PWr-M3/EuroMeasure-IonGaugeController/doc/Bottom_3D_render.png

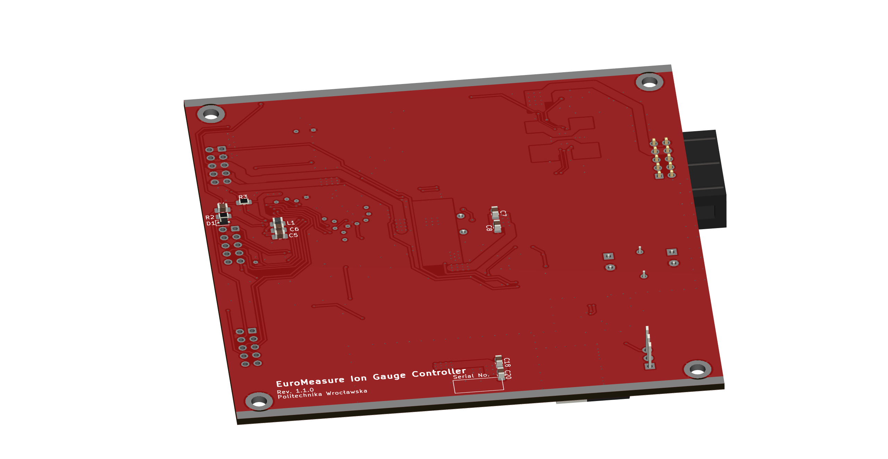
doc/Bottom_3D_render.png
