PWr-M3/EuroMeasure-IonGaugeController/doc/Top_3D_render.png

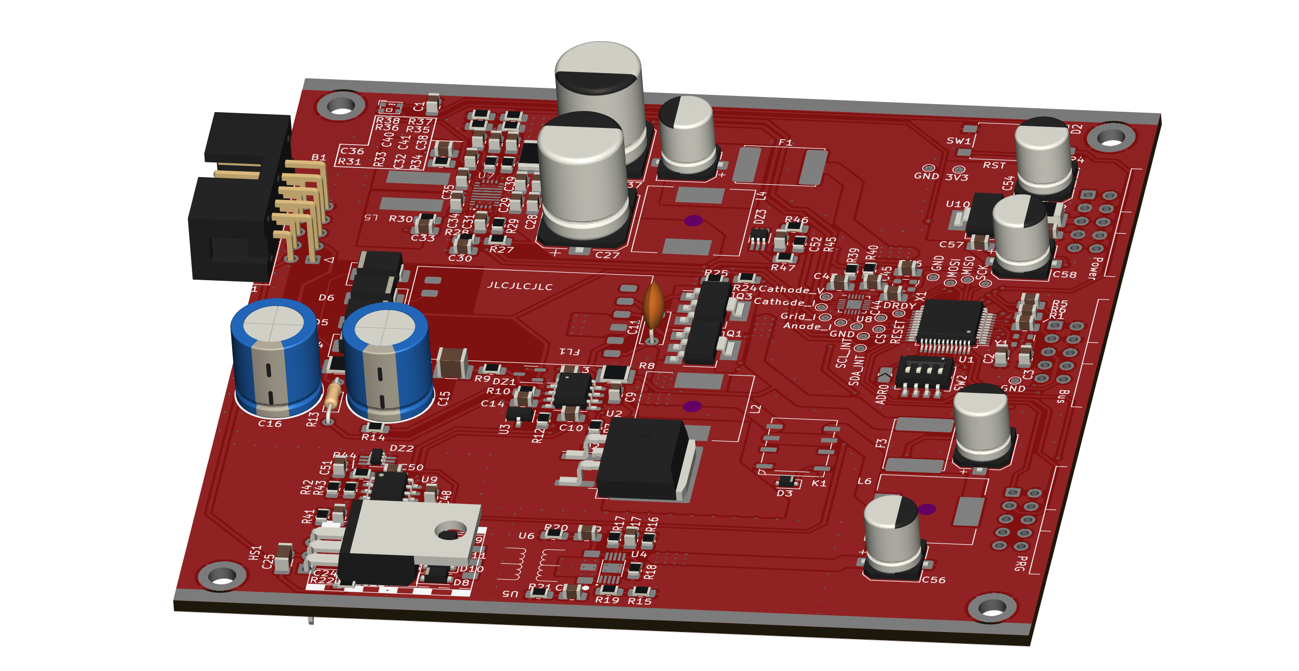
doc/Top_3D_render.png
