PWr-M3/EuroMeasure-IonGaugeController/doc/Schematic.pdf

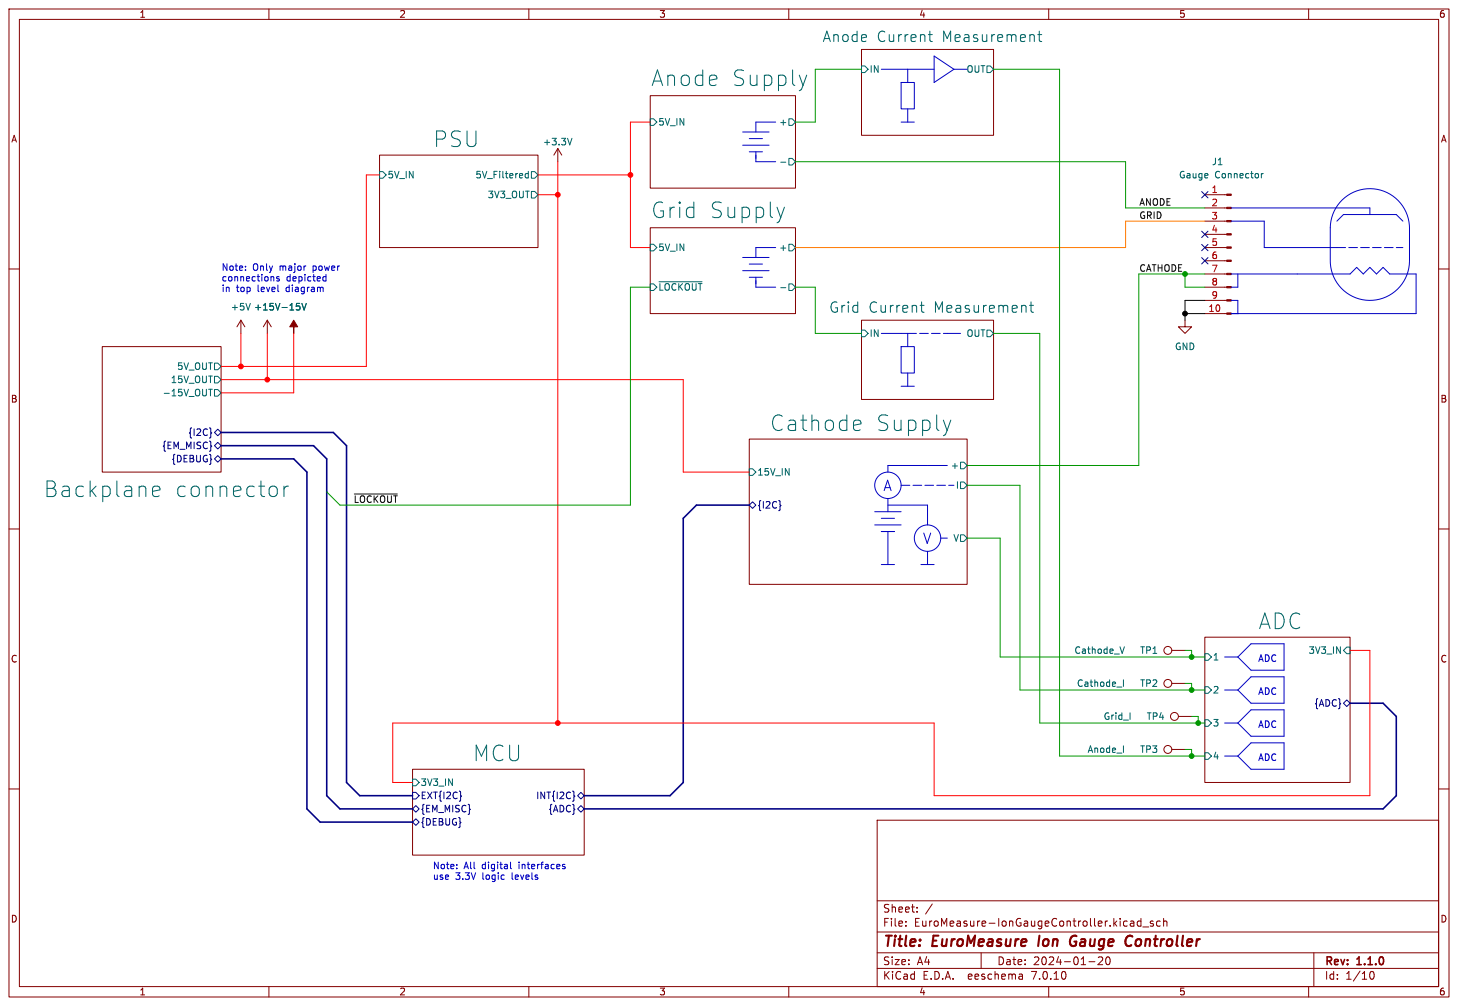
[picture p3: page 1]

in top level diagram

Id: 1/10 Title: EuroMeasure Ion Gauge Controller File: EuroMeasure-IonGaugeController.kicad_sch Sheet: /

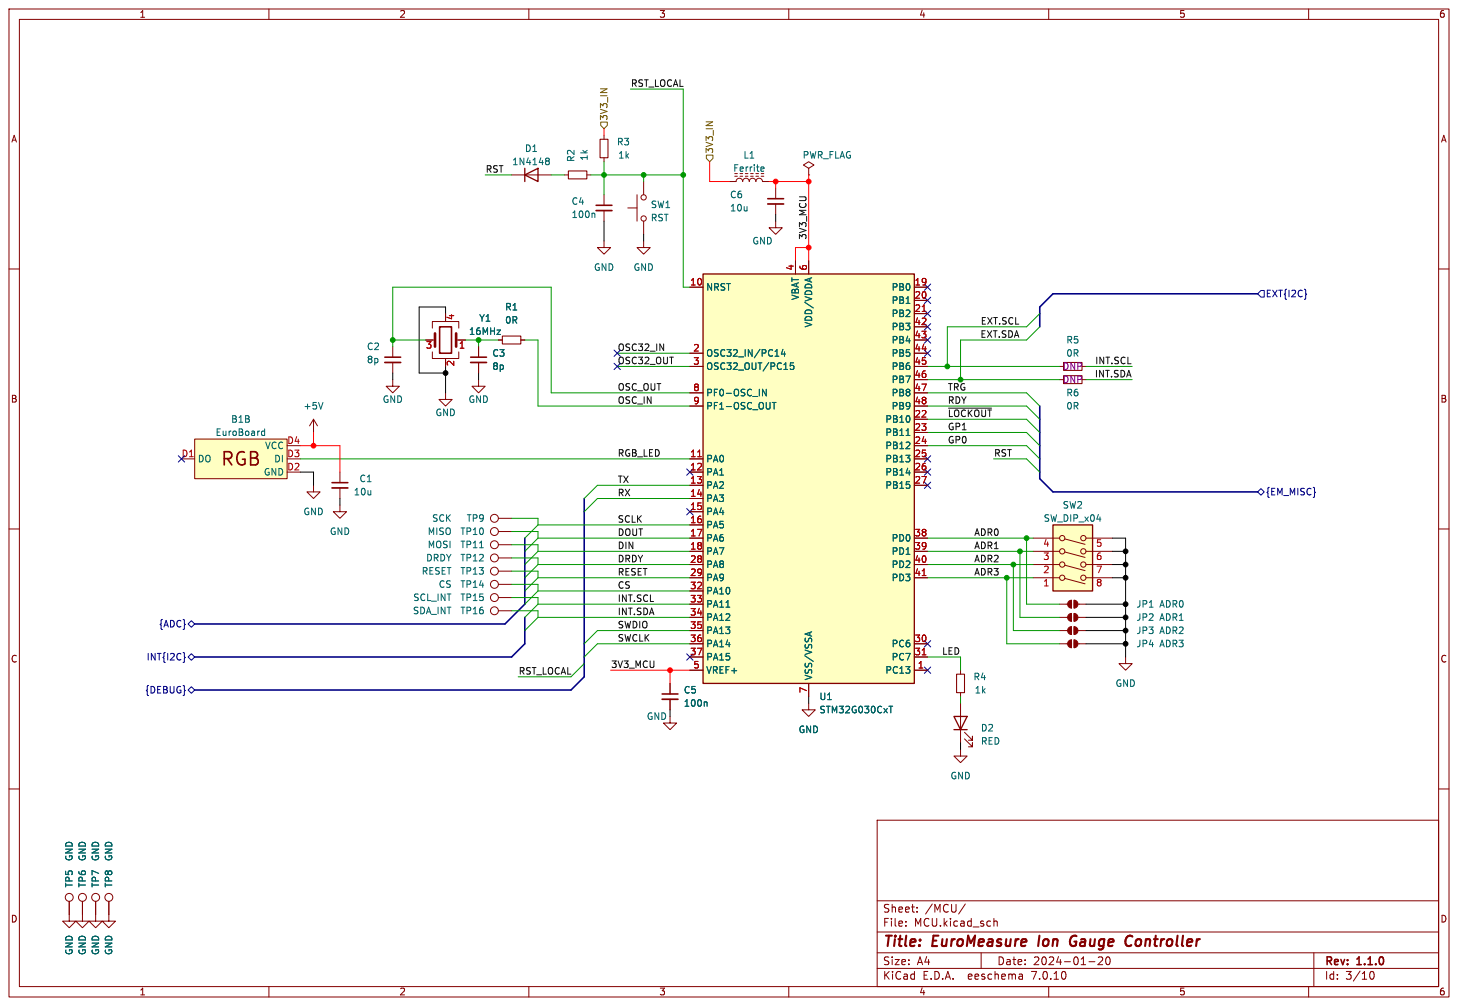
[picture p4: page 2]

EXT.SCL ~{LOCKOUT} RDY

SCLK DRDY DOUT DIN
RESET SWDIO

Id: 3/10 Title: EuroMeasure Ion Gauge Controller File: MCU.kicad_sch Sheet: /MCU/ GND

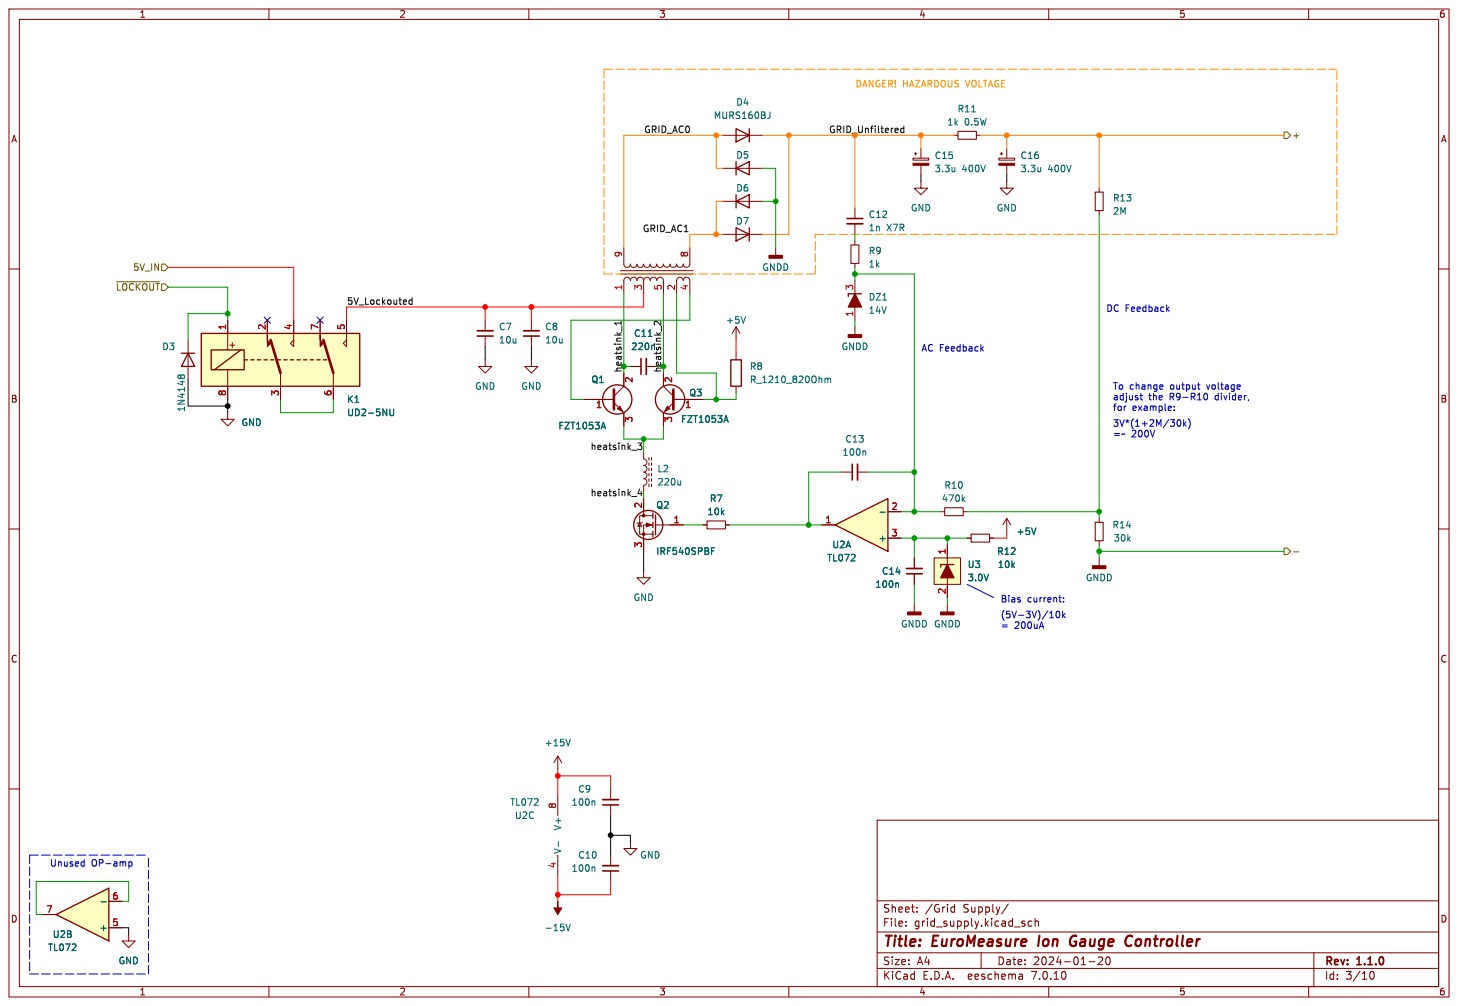
[picture p5: page 3]

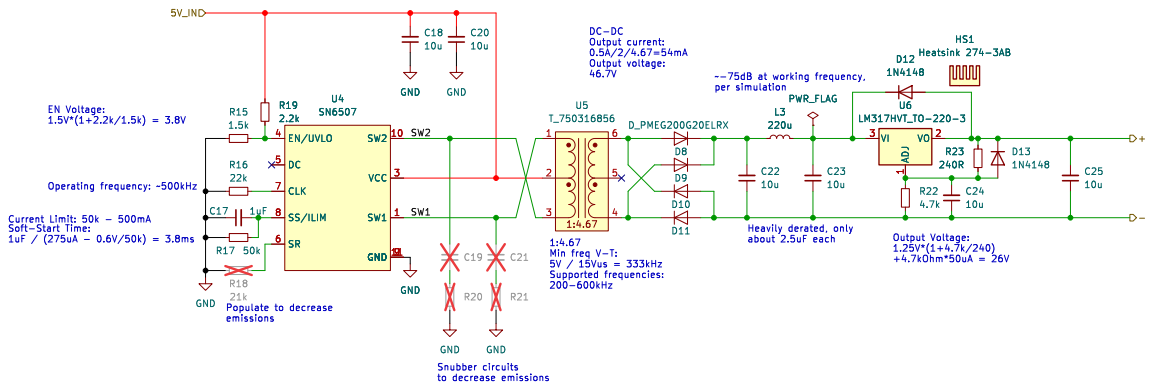
[picture p6: page 4]

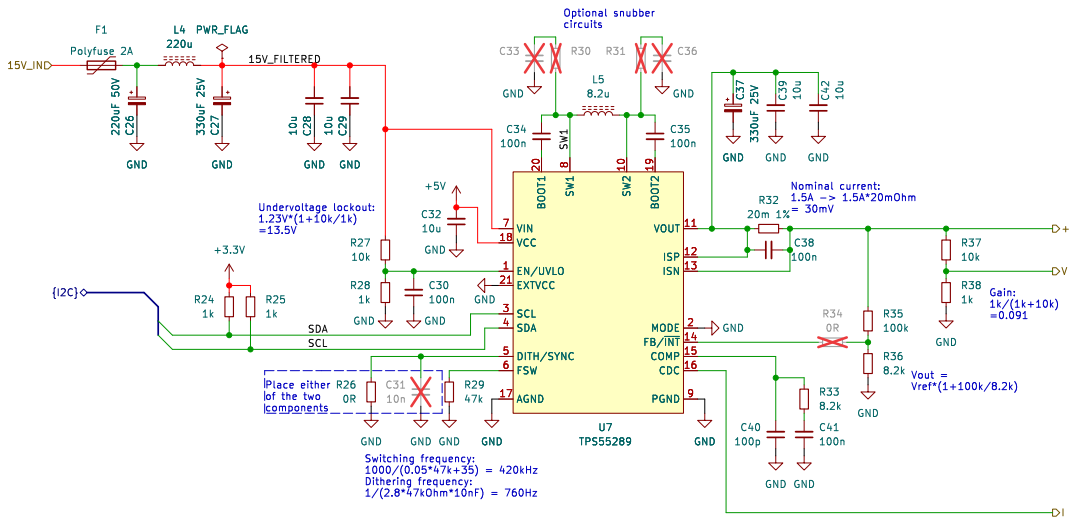
[picture p7: page 5]

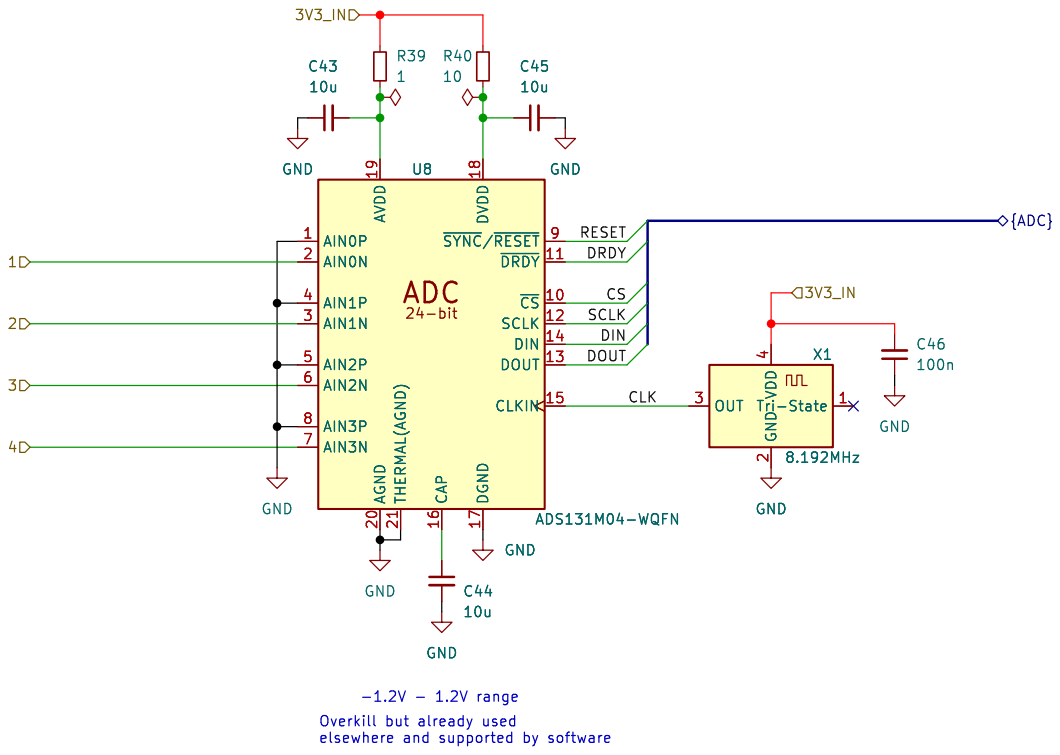
[picture p8: page 6]

{ADC} CLK DIN
SCLKCS DOUT RESET DRDY

Id: 6/10 Title: EuroMeasure Ion Gauge Controller File: adc.kicad_sch Sheet: /ADC/ GND

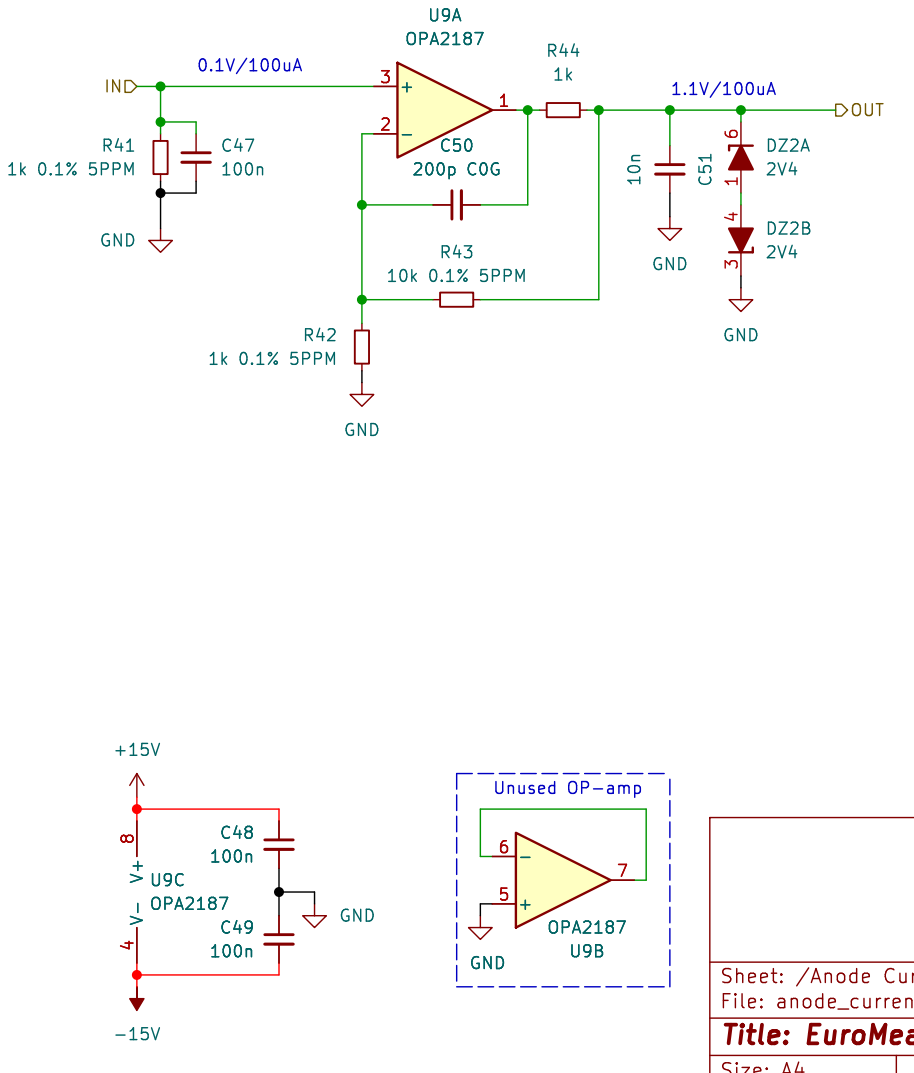
[picture p9: page 7]

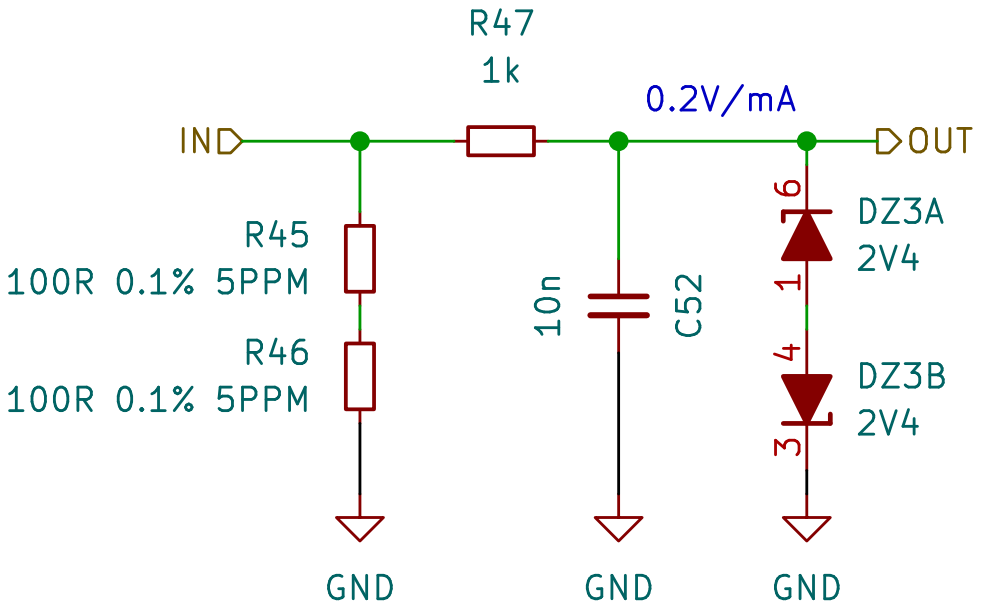
[picture p10: page 8]

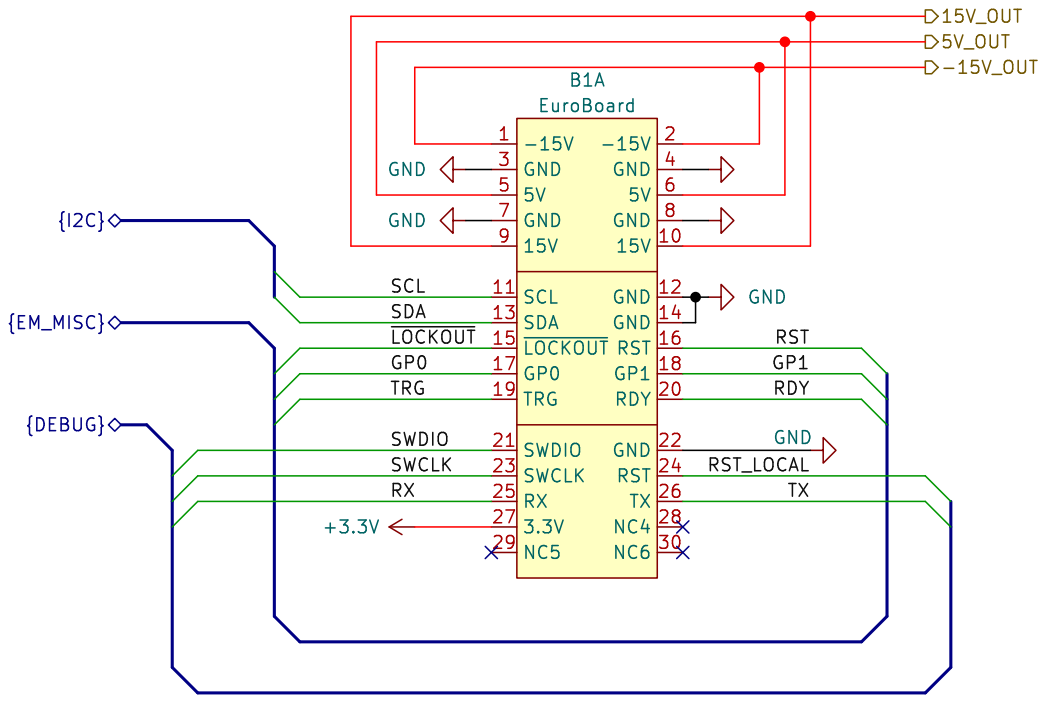
[picture p11: page 9]

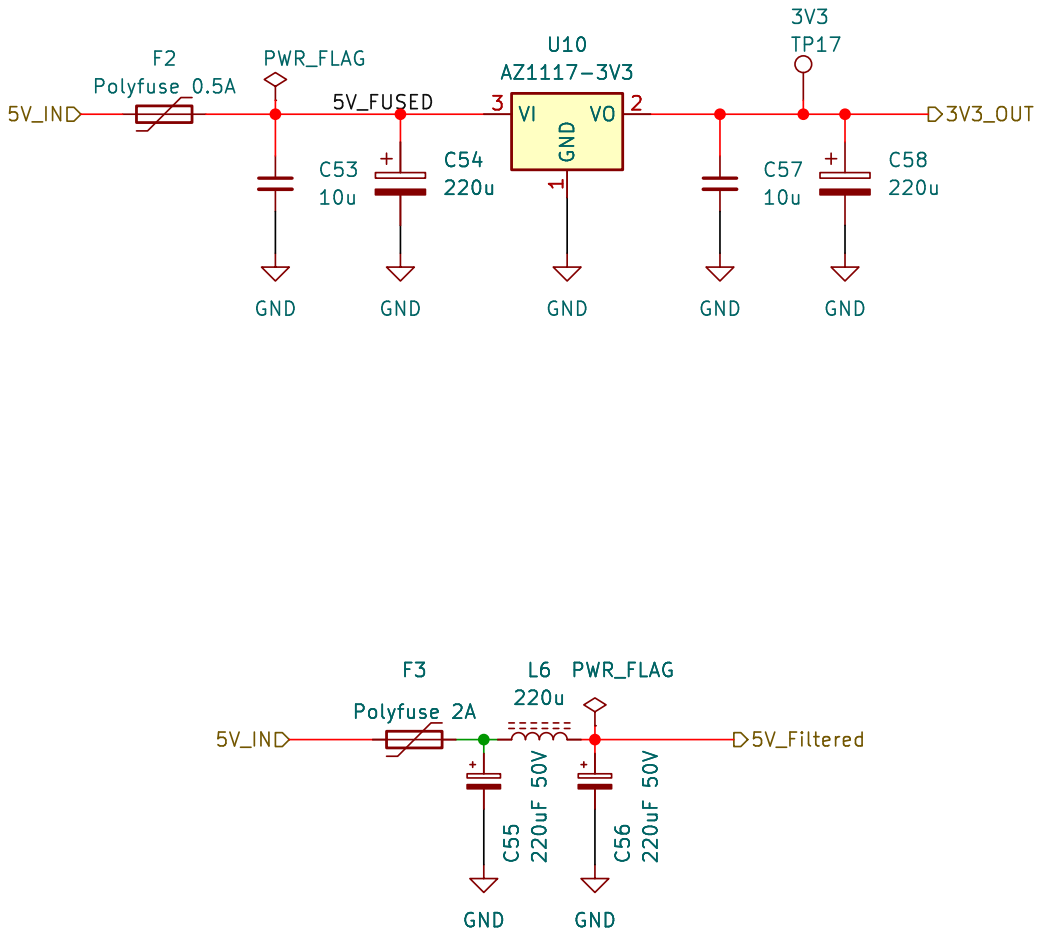
[picture p12: page 10]
