PWr-M3/EuroMeasure-IonGaugeController/doc/PCB.pdf

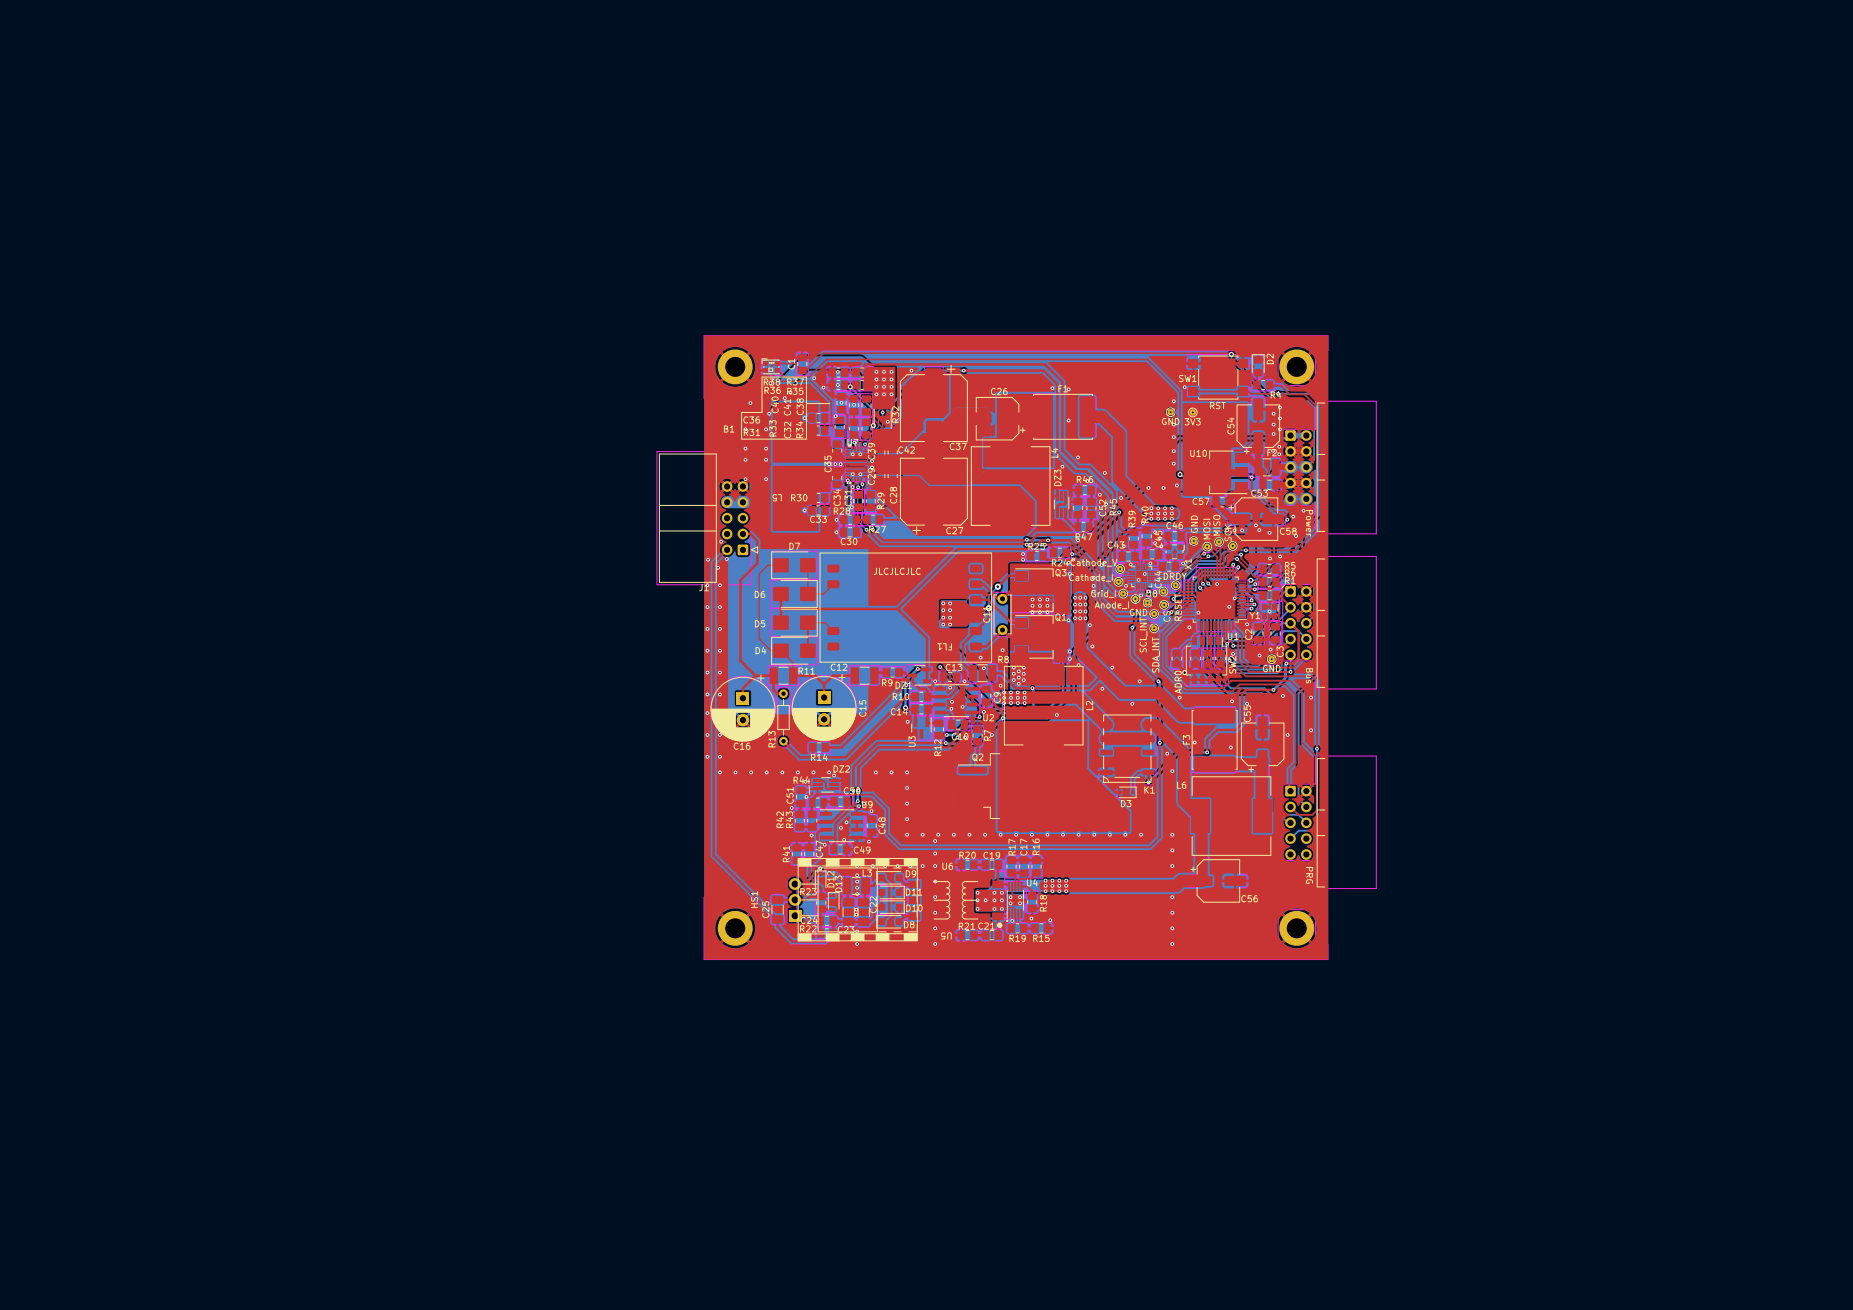
[picture p13: page 1]
