PWr-M3/EuroMeasure-IonGaugeController/EuroMeasure-IonGaugeController.kicad_pcb

## KiCad design EuroMeasure-IonGaugeController.kicad_pcb (2024-01-28)

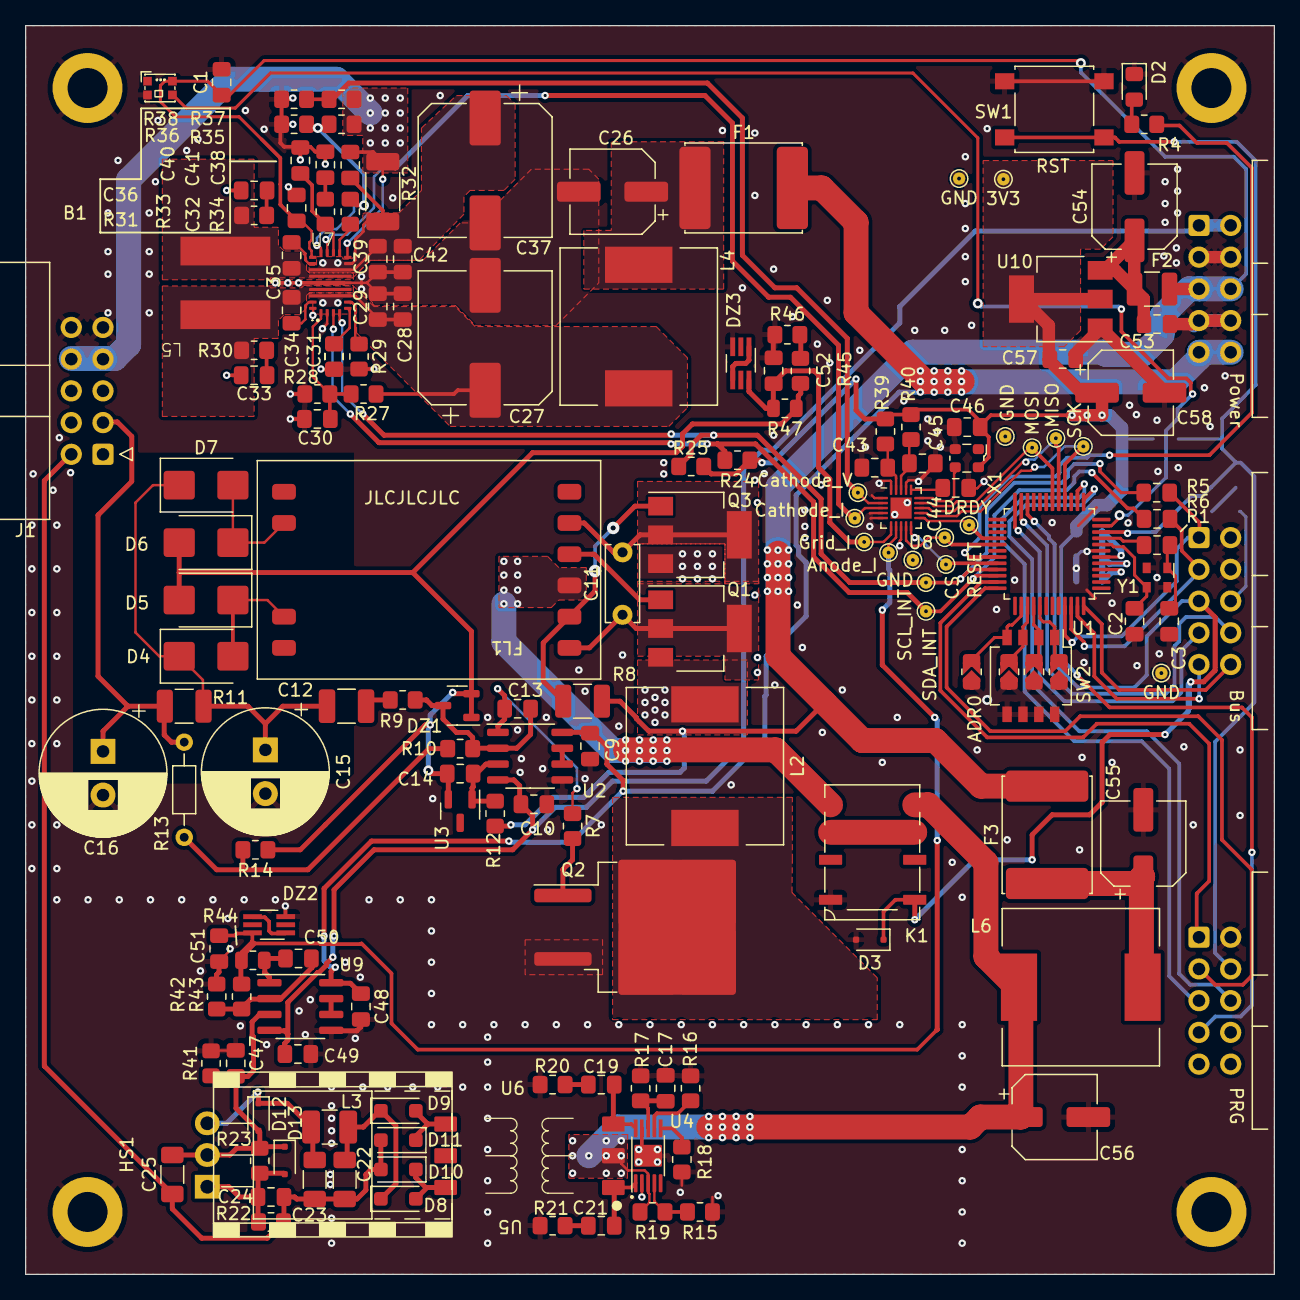
[picture p14: board EuroMeasure-IonGaugeController.kicad_pcb from above]

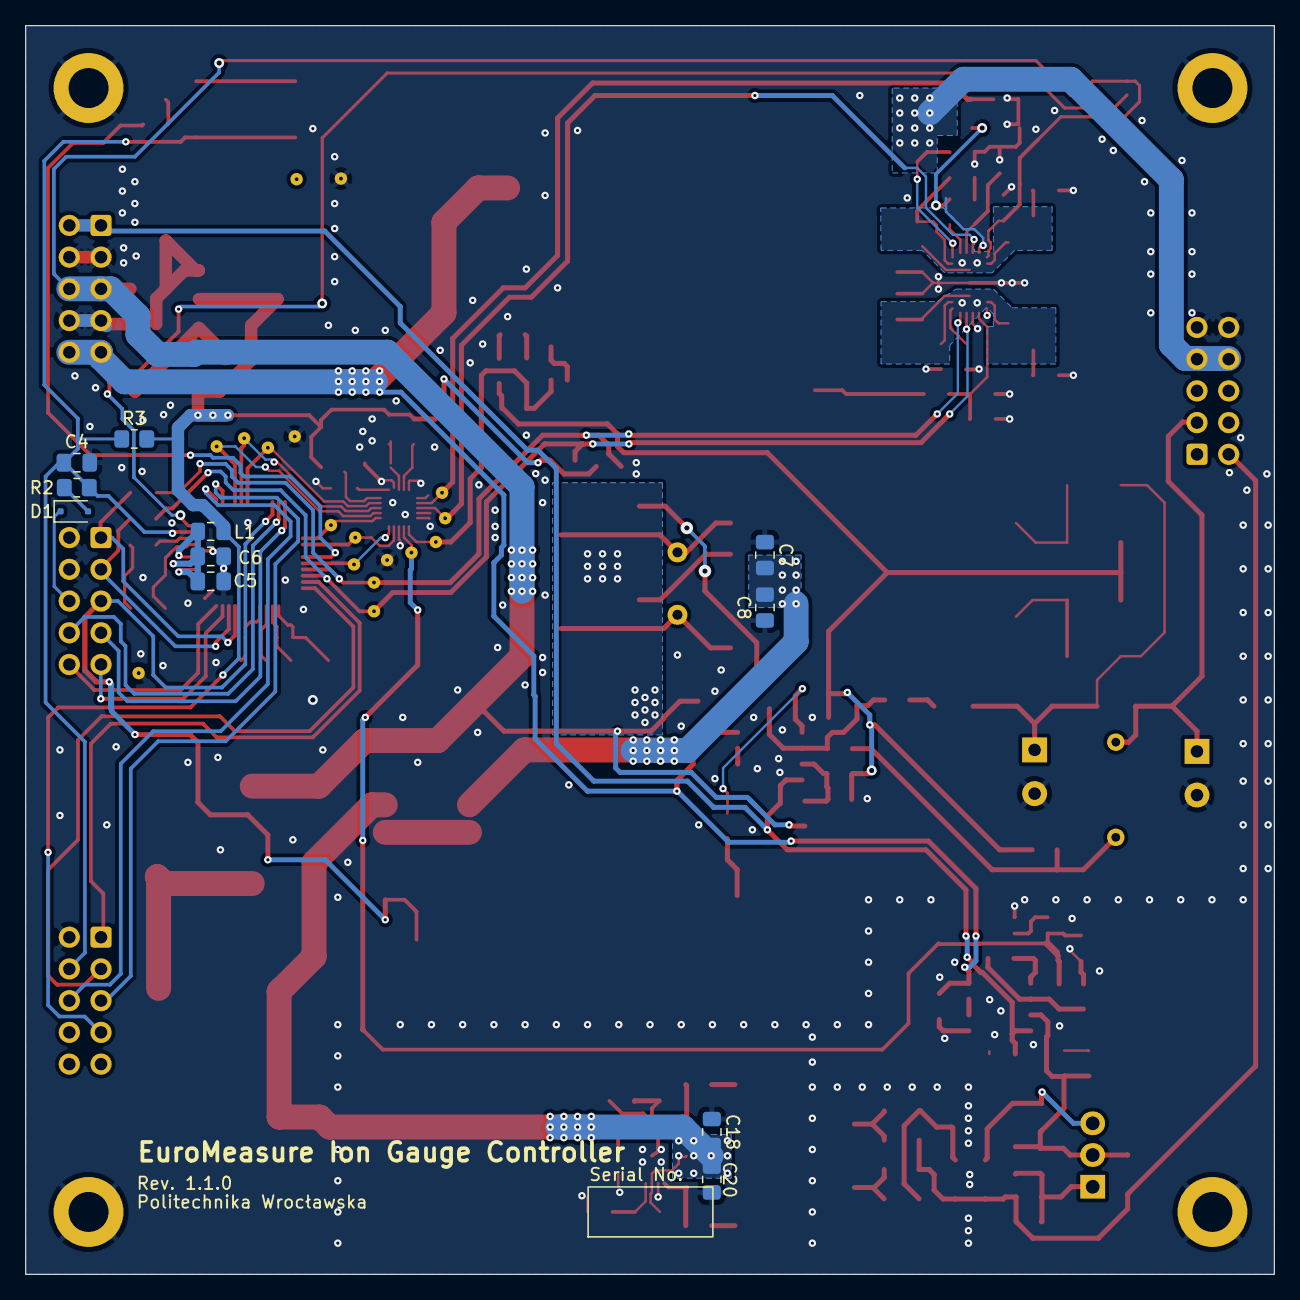
[picture p15: board EuroMeasure-IonGaugeController.kicad_pcb from below]

Board: 2 copper layers, 100.0 x 100.0 mm, 173 parts (11 on the bottom side), 107 nets.

Parts:
B1: EuroBoard; EuroMeasureLED
C1, C6, C7, C8, C18, C20, C24, C28, C29, C32, C39, C42, C43, C44, C45, C53, C57: 10u; C_0805_2012Metric_Pad1.18x1.45mm_HandSolder
C2, C3: 8p; C_0805_2012Metric_Pad1.18x1.45mm_HandSolder
C4, C5, C9, C10, C13, C14, C30, C34, C35, C38, C41, C46, C47, C48, C49: 100n; C_0805_2012Metric_Pad1.18x1.45mm_HandSolder
C11: 220n; C_Disc_D6.0mm_W2.5mm_P5.00mm
C12: 1n X7R; C_1210_3225Metric_Pad1.33x2.70mm_HandSolder
C15, C16: 3.3u 400V; CP_Radial_D10.0mm_P3.50mm
C17: 1uF; C_0805_2012Metric_Pad1.18x1.45mm_HandSolder
C19, C21, C33, C36: C_0805_2012Metric_Pad1.18x1.45mm_HandSolder
C22, C23, C25: 10u; C_1206_3216Metric_Pad1.33x1.80mm_HandSolder
C26, C55, C56: 220uF 50V; CP_Elec_6.3x7.7
C27, C37: 330uF 25V; CP_Elec_10x12.5
C31, C51, C52: 10n; C_0805_2012Metric_Pad1.18x1.45mm_HandSolder
C40: 100p; C_0805_2012Metric_Pad1.18x1.45mm_HandSolder
C50: 200p C0G; C_0805_2012Metric_Pad1.18x1.45mm_HandSolder
C54, C58: 220u; CP_Elec_6.3x7.7
D1, D3, D12, D13: 1N4148; D_SOD-323F
D2: RED; LED_0805_2012Metric_Pad1.15x1.40mm_HandSolder
D4, D5, D6, D7: MURS160BJ; D_SMB
D8: D_PMEG200G20ELRX; D_SOD-123F
D9, D10, D11: MURS160BJ; D_SOD-123F
DZ1: 14V; SOT-23-3
DZ2, DZ3: 2V4; SOT-363_SC-70-6_Handsoldering
F1, F3: Polyfuse 2A; Fuse_Littlefuse_3425L
F2: Polyfuse 0.5A; Fuse_1210_3225Metric
FL1: FL2015-4L; T_FL2015
HS1: Heatsink 274-3AB; 274-3AB
J1: Gauge Connector; IDC-Header_2x05_P2.54mm_Horizontal
JP1: ADR0; R_0805_2012Metric_Jumper
JP2: ADR1; R_0805_2012Metric_Jumper
JP3: ADR2; R_0805_2012Metric_Jumper
JP4: ADR3; R_0805_2012Metric_Jumper
K1: UD2-5NU; Relay_DPDT_Kemet_UC2_NU
L1: Ferrite; L_0805_2012Metric_Pad1.15x1.40mm_HandSolder
L2, L4, L6: 220u; L_12x12mm_H8mm
L3: 220u; L_1210_3225Metric_Pad1.42x2.65mm_HandSolder
L5: 8.2u; L_Bourns_SRP7030
Q1, Q3: FZT1053A; SOT-223-3_TabPin2
Q2: IRF540SPBF; TO-263-2
R1, R5, R6: 0R; C_0805_2012Metric_Pad1.18x1.45mm_HandSolder
R2, R3, R4, R9, R24, R25, R28, R38: 1k; R_0805_2012Metric_Pad1.20x1.40mm_HandSolder
R7, R12, R27, R37: 10k; R_0805_2012Metric_Pad1.20x1.40mm_HandSolder
R8: R_1210_820Ohm; R_1210_3225Metric_Pad1.30x2.65mm_HandSolder
R10: 470k; R_0805_2012Metric_Pad1.20x1.40mm_HandSolder
R11: 1k 0.5W; R_1210_3225Metric_Pad1.30x2.65mm_HandSolder
R13: 2M; R_Axial_DIN0204_L3.6mm_D1.6mm_P7.62mm_Horizontal
R14: 30k; R_0805_2012Metric_Pad1.20x1.40mm_HandSolder
R15: 1.5k; R_0805_2012Metric_Pad1.20x1.40mm_HandSolder
R16: 22k; R_0805_2012Metric_Pad1.20x1.40mm_HandSolder
R17: 50k; R_0805_2012Metric_Pad1.20x1.40mm_HandSolder
R18: 21k; R_0805_2012Metric_Pad1.20x1.40mm_HandSolder
R19: 2.2k; R_0805_2012Metric_Pad1.20x1.40mm_HandSolder
R20, R21, R30, R31: R_0805_2012Metric_Pad1.20x1.40mm_HandSolder
R22: 4.7k; R_0805_2012Metric_Pad1.20x1.40mm_HandSolder
R23: 240R; R_0805_2012Metric_Pad1.20x1.40mm_HandSolder
R26, R34: 0R; R_0805_2012Metric_Pad1.20x1.40mm_HandSolder
R29: 47k; R_0805_2012Metric_Pad1.20x1.40mm_HandSolder
R32: 20m 1%; R_2010_5025Metric_Pad1.40x2.65mm_HandSolder
R33, R36: 8.2k; R_0805_2012Metric_Pad1.20x1.40mm_HandSolder
R35: 100k; R_0805_2012Metric_Pad1.20x1.40mm_HandSolder
R39: 1; R_0805_2012Metric_Pad1.20x1.40mm_HandSolder
R40: 10; R_0805_2012Metric_Pad1.20x1.40mm_HandSolder
R41, R42: 1k 0.1% 5PPM; R_0805_2012Metric_Pad1.20x1.40mm_HandSolder
R43: 10k 0.1% 5PPM; R_0805_2012Metric_Pad1.20x1.40mm_HandSolder
R44, R47: 1k; R_0805_2012Metric
R45, R46: 100R 0.1% 5PPM; R_0805_2012Metric_Pad1.20x1.40mm_HandSolder
SW1: RST; SW_SPST_B3S-1000
SW2: SW_DIP_x04; SW_DIP_SPSTx04_Slide_Omron_A6H-4101_W6.15mm_P1.27mm
TP1: Cathode_V; TestPoint_Pad_D1.0mm
TP2: Cathode_I; TestPoint_Pad_D1.0mm
TP3: Anode_I; TestPoint_Pad_D1.0mm
TP4: Grid_I; TestPoint_Pad_D1.0mm
TP5, TP6, TP7, TP8: GND; TestPoint_Pad_D1.0mm
TP9: SCK; TestPoint_Pad_D1.0mm
TP10: MISO; TestPoint_Pad_D1.0mm
TP11: MOSI; TestPoint_Pad_D1.0mm
TP12: DRDY; TestPoint_Pad_D1.0mm
TP13: RESET; TestPoint_Pad_D1.0mm
TP14: CS; TestPoint_Pad_D1.0mm
TP15: SCL_INT; TestPoint_Pad_D1.0mm
TP16: SDA_INT; TestPoint_Pad_D1.0mm
TP17: 3V3; TestPoint_Pad_D1.0mm
U1: STM32G030CxT; LQFP-48_7x7mm_P0.5mm
U2: TL072; SO-8_3.9x4.9mm_P1.27mm
U3: 3.0V; SOT-23
U4: SN6507
U5: T_750316856; 750316856
U6: LM317HVT_TO-220-3; TO-220-3_Horizontal_TabUp
U7: TPS55289
U8: ADS131M04-WQFN; WQFN-20-1EP_3x3mm_P0.4mm_EP1.7x1.7mm
U9: OPA2187; SOIC-8_3.9x4.9mm_P1.27mm
U10: AZ1117-3V3; SOT-223-3_TabPin2
X1: 8.192MHz; Oscillator_SMD_ECS_2520MV-xxx-xx-4Pin_2.5x2.0mm
Y1: 16MHz; Oscillator_SMD_Abracon_ASDMB-4Pin_2.5x2.0mm

Connections:
+3.3V: B1.27 (3.3V), C46.2, C57.1, C58.1, L1.1, R3.2, R24.1, R25.1, R39.2, R40.2, TP17.1, U10.2 (VO), X1.4 (VDD)
+5V: B1.5 (5V), B1.6 (5V), B1.D4 (VCC), C1.1, C32.2, F2.1, F3.2, R8.2, R12.1, U7.18 (VCC)
+15V: B1.9 (15V), B1.10 (15V), C9.2, C48.1, F1.2, U2.8 (V+), U9.8 (V+)
-15V: B1.1 (-15V), B1.2 (-15V), C10.1, C49.2, U2.4 (V-), U9.4 (V-)
/ADC/1: R37.2, R38.1, TP1.1, U8.2 (AIN0N)
/ADC/2: TP2.1, U7.16 (CDC), U8.3 (AIN1N)
/ADC/3: C52.1, DZ3.6 (K), R47.2, TP4.1, U8.6 (AIN2N)
/ADC/4: C51.1, DZ2.6 (K), R43.2, R44.2, TP3.1, U8.7 (AIN3N)
/ADC/CLK: U8.15 (CLKIN), X1.3 (OUT)
/ADC/CS: TP14.1, U1.32 (PA10), U8.10 (~CS)
/ADC/DIN: TP11.1, U1.18 (PA7), U8.14 (DIN)
/ADC/DOUT: TP10.1, U1.17 (PA6), U8.13 (DOUT)
/ADC/DRDY: TP12.1, U1.28 (PA8), U8.11 (~DRDY)
/ADC/RESET: TP13.1, U1.29 (PA9), U8.9 (~SYNC/~RESET)
/ADC/SCLK: TP9.1, U1.16 (PA5), U8.12 (SCLK)
/ANODE: C22.1, C23.1, C24.1, C25.1, D10.2 (A), D11.2 (A), J1.2, R22.2
/Anode Current Measurement/IN: C25.2, C47.1, D12.2 (A), D13.1 (K), R23.1, R41.1, U6.2 (VO), U9.3 (+)
/Anode Supply/5V_IN: C18.2, C20.2, C56.1, K1.4, L6.2, R19.2, U4.3 (VCC), U5.2
/Anode Supply/SW1: C21.1, U4.1 (SW1), U5.1
/Anode Supply/SW2: C19.1, U4.10 (SW2), U5.3
/Backplane connector/GP0: B1.17 (GP0), U1.24 (PB12)
/Backplane connector/GP1: B1.18 (GP1), U1.23 (PB11)
/Backplane connector/RDY: B1.20 (RDY), U1.48 (PB9)
/Backplane connector/RST: B1.16 (RST), D1.1 (K)
/Backplane connector/RST_LOCAL: B1.24 (RST), C4.1, R2.1, R3.1, SW1.2, U1.10 (NRST)
/Backplane connector/RX: B1.25 (RX), U1.14 (PA3)
/Backplane connector/SCL: B1.11 (SCL), R5.1, U1.45 (PB6)
/Backplane connector/SDA: B1.13 (SDA), R6.2, U1.46 (PB7)
/Backplane connector/SWCLK: B1.23 (SWCLK), U1.36 (PA14)
/Backplane connector/SWDIO: B1.21 (SWDIO), U1.35 (PA13)
/Backplane connector/TRG: B1.19 (TRG), U1.47 (PB8)
/Backplane connector/TX: B1.26 (TX), U1.13 (PA2)
/Backplane connector/~LOCKOUT: B1.15 (~LOCKOUT), D3.1 (K), K1.1, U1.22 (PB10)
/CATHODE: C38.2, J1.7, J1.8, R32.2, R35.1, R37.1, U7.13 (ISN)
/Cathode Supply/15V_FILTERED: C27.1, C28.2, C29.2, L4.2, R27.1, U7.7 (VIN)
/Cathode Supply/SCL: R5.2, R25.2, TP15.1, U1.33 (PA11), U7.4 (SDA)
/Cathode Supply/SDA: R6.1, R24.2, TP16.1, U1.34 (PA12), U7.3 (SCL)
/Cathode Supply/SW1: C34.1, L5.1, R30.2, U7.8 (SW1)
/GRID: C16.1, J1.3, R11.2, R13.2
/Grid Supply/5V_Lockouted: C7.2, C8.2, FL1.3, K1.5
/Grid Supply/GRID_AC0: D4.2 (A), D5.1 (K), FL1.9
/Grid Supply/GRID_AC1: D6.1 (K), D7.2 (A), FL1.8
/Grid Supply/GRID_Unfiltered: C12.1, C15.1, D4.1 (K), D7.1 (K), R11.1
/Grid Supply/heatsink_1: C11.1, FL1.1, Q1.2 (C)
/Grid Supply/heatsink_2: C11.2, FL1.5, Q3.2 (C)
/Grid Supply/heatsink_3: L2.1, Q1.3 (E), Q3.3 (E)
/Grid Supply/heatsink_4: L2.2, Q2.2 (D)
/MCU/3V3_MCU: C5.1, C6.1, L1.2, U1.4 (VBAT), U1.5 (VREF+), U1.6 (VDD/VDDA)
/MCU/ADR0: JP1.1, SW2.4, U1.38 (PD0)
/MCU/ADR1: JP2.1, SW2.3, U1.39 (PD1)
/MCU/ADR2: JP3.1, SW2.2, U1.40 (PD2)
/MCU/ADR3: JP4.1, SW2.1, U1.41 (PD3)
/MCU/LED: R4.2, U1.31 (PC7)
/MCU/OSC_IN: R1.2, U1.9 (PF1-OSC_OUT)
/MCU/OSC_OUT: C2.1, U1.8 (PF0-OSC_IN), Y1.3
/MCU/RGB_LED: B1.D3 (DI), U1.11 (PA0)
/PSU/5V_FUSED: C53.1, C54.1, F2.2, U10.3 (VI)
GND: B1.3 (GND), B1.4 (GND), B1.7 (GND), B1.8 (GND), B1.12 (GND), B1.14 (GND), B1.22 (GND), B1.D2 (GND), C1.2, C2.2, C3.2, C4.2, C5.2, C6.2, C7.1, C8.1, C9.1, C10.2, C15.2, C16.2, C17.1, C18.1, C20.1, C26.2, C27.2, C28.1, C29.1, C30.1, C31.2, C32.1, C33.2, C36.2, C37.2, C39.1, C40.1, C41.1, C42.1, C43.1, C44.2, C45.2, C46.1, C47.2, C48.2, C49.1, C51.2, C52.2, C53.2, C54.2, C55.2, C56.2, C57.2, C58.2, D2.1 (K), D3.2 (A), DZ2.3 (K), DZ3.3 (K), J1.9, J1.10, JP1.2, JP2.2, JP3.2, JP4.2, K1.8, Q2.3 (S), R15.1, R16.1, R17.1, R18.1, R20.2, R21.2, R26.2, R28.2, R29.2, R36.2, R38.2, R41.2, R42.2, R46.2, SW1.1, SW2.5, SW2.6, SW2.7, SW2.8, TP5.1, TP6.1, TP7.1, TP8.1, U1.7 (VSS/VSSA), U2.5 (+), U4.2 (GND), U4.9 (GND), U4.11 (GND), U7.2 (MODE), U7.9 (PGND), U7.17 (AGND), U7.21 (EXTVCC), U8.1 (AIN0P), U8.4 (AIN1P), U8.5 (AIN2P), U8.8 (AIN3P), U8.17 (DGND), U8.20 (AGND), U8.21 (THERMAL(AGND)), U9.5 (+), U10.1 (GND), X1.2 (GND), Y1.2, Y1.4
GNDD: C14.1, D5.2 (A), D6.2 (A), DZ1.1 (A), DZ1.2 (A), R14.1, R45.1, R47.1, U3.2 (A)
unnamed: C3.1, R1.1, Y1.1
unnamed: C12.2, R9.1
unnamed: C13.1, R7.1, U2.1
unnamed: C19.2, R20.1
unnamed: C21.2, R21.1
unnamed: C26.1, F1.1, L4.1
unnamed: C33.1, R30.1
unnamed: C36.1, R31.1
unnamed: C41.2, R33.2
unnamed: C50.2, R44.1, U9.1
unnamed: C55.1, F3.1, L6.1
unnamed: D1.2 (A), R2.2
unnamed: D2.2 (A), R4.1
unnamed: C22.2, D8.1 (K), D9.1 (K), L3.1
unnamed: D8.2 (A), D10.1 (K), U5.6
unnamed: D9.2 (A), D11.1 (K), U5.4
unnamed: C23.2, D12.1 (K), L3.2, U6.3 (VI)
unnamed: C24.2, D13.2 (A), R22.1, R23.2, U6.1 (ADJ)
unnamed: C13.2, DZ1.3 (K), R9.2, R10.2, U2.2 (-)
unnamed: DZ2.1 (A), DZ2.4 (A)
unnamed: DZ3.1 (A), DZ3.4 (A)
unnamed: K1.3, K1.6
unnamed: FL1.4, Q1.1 (B)
unnamed: Q2.1 (G), R7.2
unnamed: FL1.2, Q3.1 (B), R8.1
unnamed: R10.1, R13.1, R14.2
unnamed: R34.2, R35.2, R36.1
unnamed: R45.2, R46.1
unnamed: C14.2, R12.2, U2.3 (+), U3.1 (K)
unnamed: U2.6 (-), U2.7
unnamed: R16.2, U4.7 (CLK)
unnamed: R15.2, R19.1, U4.4 (EN/UVLO)
unnamed: R18.2, U4.6 (SR)
unnamed: C17.2, R17.2, U4.8 (SS/ILIM)
unnamed: C34.2, U7.20 (BOOT1)
unnamed: C35.2, U7.19 (BOOT2)
unnamed: C40.2, R33.1, U7.15 (COMP)
unnamed: C31.1, R26.1, U7.5 (DITH/SYNC)
unnamed: C30.2, R27.2, R28.1, U7.1 (EN/UVLO)
unnamed: R34.1, U7.14 (FB/~INT)
unnamed: R29.1, U7.6 (FSW)
unnamed: C37.1, C38.1, C39.2, C42.2, R32.1, U7.11 (VOUT), U7.12 (ISP)
unnamed: C35.1, L5.2, R31.2, U7.10 (SW2)
unnamed: C43.2, R39.1, U8.19 (AVDD)
unnamed: C44.1, U8.16 (CAP)
unnamed: C45.1, R40.1, U8.18 (DVDD)
unnamed: C50.1, R42.1, R43.1, U9.2 (-)
unnamed: U9.6 (-), U9.7
