PWr-M3/EuroMeasure-IonGaugeController/(commit log)

2023-10-17 Rename to Ion Gauge Controller
    [EuroMeasure-IonGaugeController.kicad_pcb, EuroMeasure-IonGaugeController.kicad_sch]
2023-10-17 First schematic draft
    [EuroMeasure-IonGaugeController.kicad_sch, anode_supply.kicad_sch, cathode_supply.kicad_sch, grid_supply.kicad_sch]
2023-11-04 A lot of work
    [EuroMeasure-IonGaugeController.kicad_pcb, EuroMeasure-IonGaugeController.kicad_sch, anode_supply.kicad_sch, cathode_supply.kicad_sch, grid_supply.kicad_sch]
2023-11-11 Copper layout done
    [EuroMeasure-IonGaugeController.kicad_pcb, EuroMeasure-IonGaugeController.kicad_sch, anode_supply.kicad_sch, cathode_supply.kicad_sch, grid_supply.kicad_sch]
2023-11-11 Clean DRC
    [EuroMeasure-IonGaugeController.kicad_pcb]
2023-12-09 Final 1.0.0 version
    [EuroMeasure-IonGaugeController.kicad_pcb, EuroMeasure-IonGaugeController.kicad_sch, anode_supply.kicad_sch, grid_supply.kicad_sch]
2023-12-09 Generated BOM and found replacements
    [Mouser.csv]
2023-12-09 Generated gerbers
    [EuroMeasure-IonGaugeController-B_Cu.gbl, EuroMeasure-IonGaugeController-B_Mask.gbs, EuroMeasure-IonGaugeController-B_Paste.gbp, EuroMeasure-IonGaugeController-B_Silkscreen.gbo, EuroMeasure-IonGaugeController-Edge_Cuts.gm1, EuroMeasure-IonGaugeController-F_Cu.gtl, EuroMeasure-IonGaugeController-F_Mask.gts, EuroMeasure-IonGaugeController-F_Paste.gtp]
2024-01-20 Revision 1.1.0. DRC clean
    [EuroMeasure-IonGaugeController.kicad_pcb, EuroMeasure-IonGaugeController.kicad_sch, MCU.kicad_sch, adc.kicad_sch, anode_ammeter.kicad_sch, anode_current_measurement.kicad_sch, anode_supply.kicad_sch, backplane_connector.kicad_sch]
2024-01-28 Everything clear. Gerbers generated
    [EuroMeasure-IonGaugeController-B_Cu.gbl, EuroMeasure-IonGaugeController-B_Mask.gbs, EuroMeasure-IonGaugeController-B_Paste.gbp, EuroMeasure-IonGaugeController-B_Silkscreen.gbo, EuroMeasure-IonGaugeController-Edge_Cuts.gm1, EuroMeasure-IonGaugeController-F_Cu.gtl, EuroMeasure-IonGaugeController-F_Mask.gts, EuroMeasure-IonGaugeController-F_Paste.gtp]
2024-01-28 Exported auxiliary files
    [EuroMeasure-IonGaugeController.kicad_pcb, EuroMeasure-IonGaugeController.kicad_sch, Lab.csv, MCU.kicad_sch, Mouser.csv, adc.kicad_sch, anode_current_measurement.kicad_sch, anode_supply.kicad_sch]
